matt-kosman/horticulture_panel/build/horticulture_panel_revA_schematic.pdf

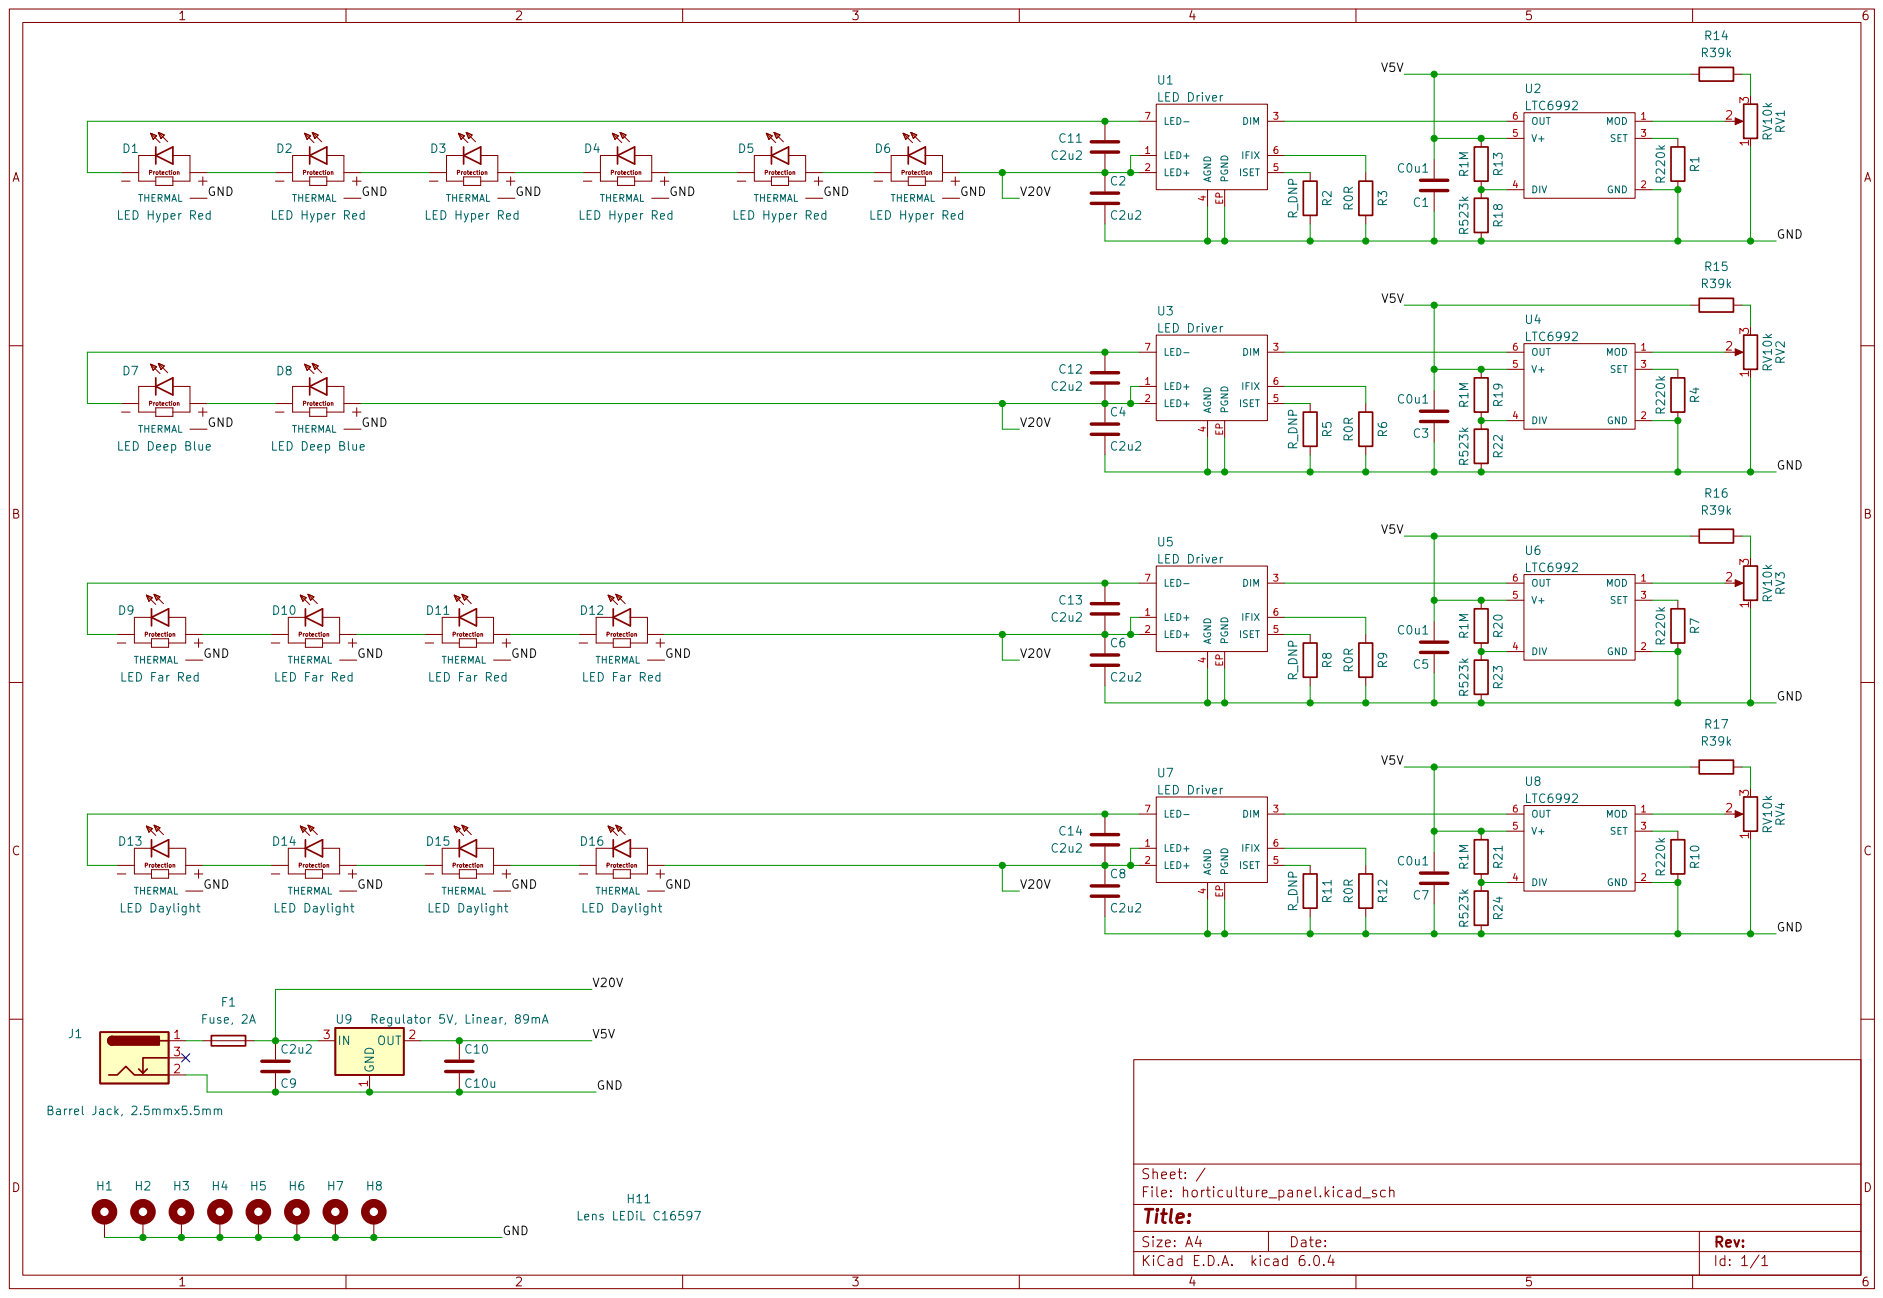
[picture p12: page 1]
