matt-kosman/horticulture_panel/kicad/horticulture_panel.kicad_pcb

## KiCad design kicad/horticulture_panel.kicad_pcb (2022-03-29)

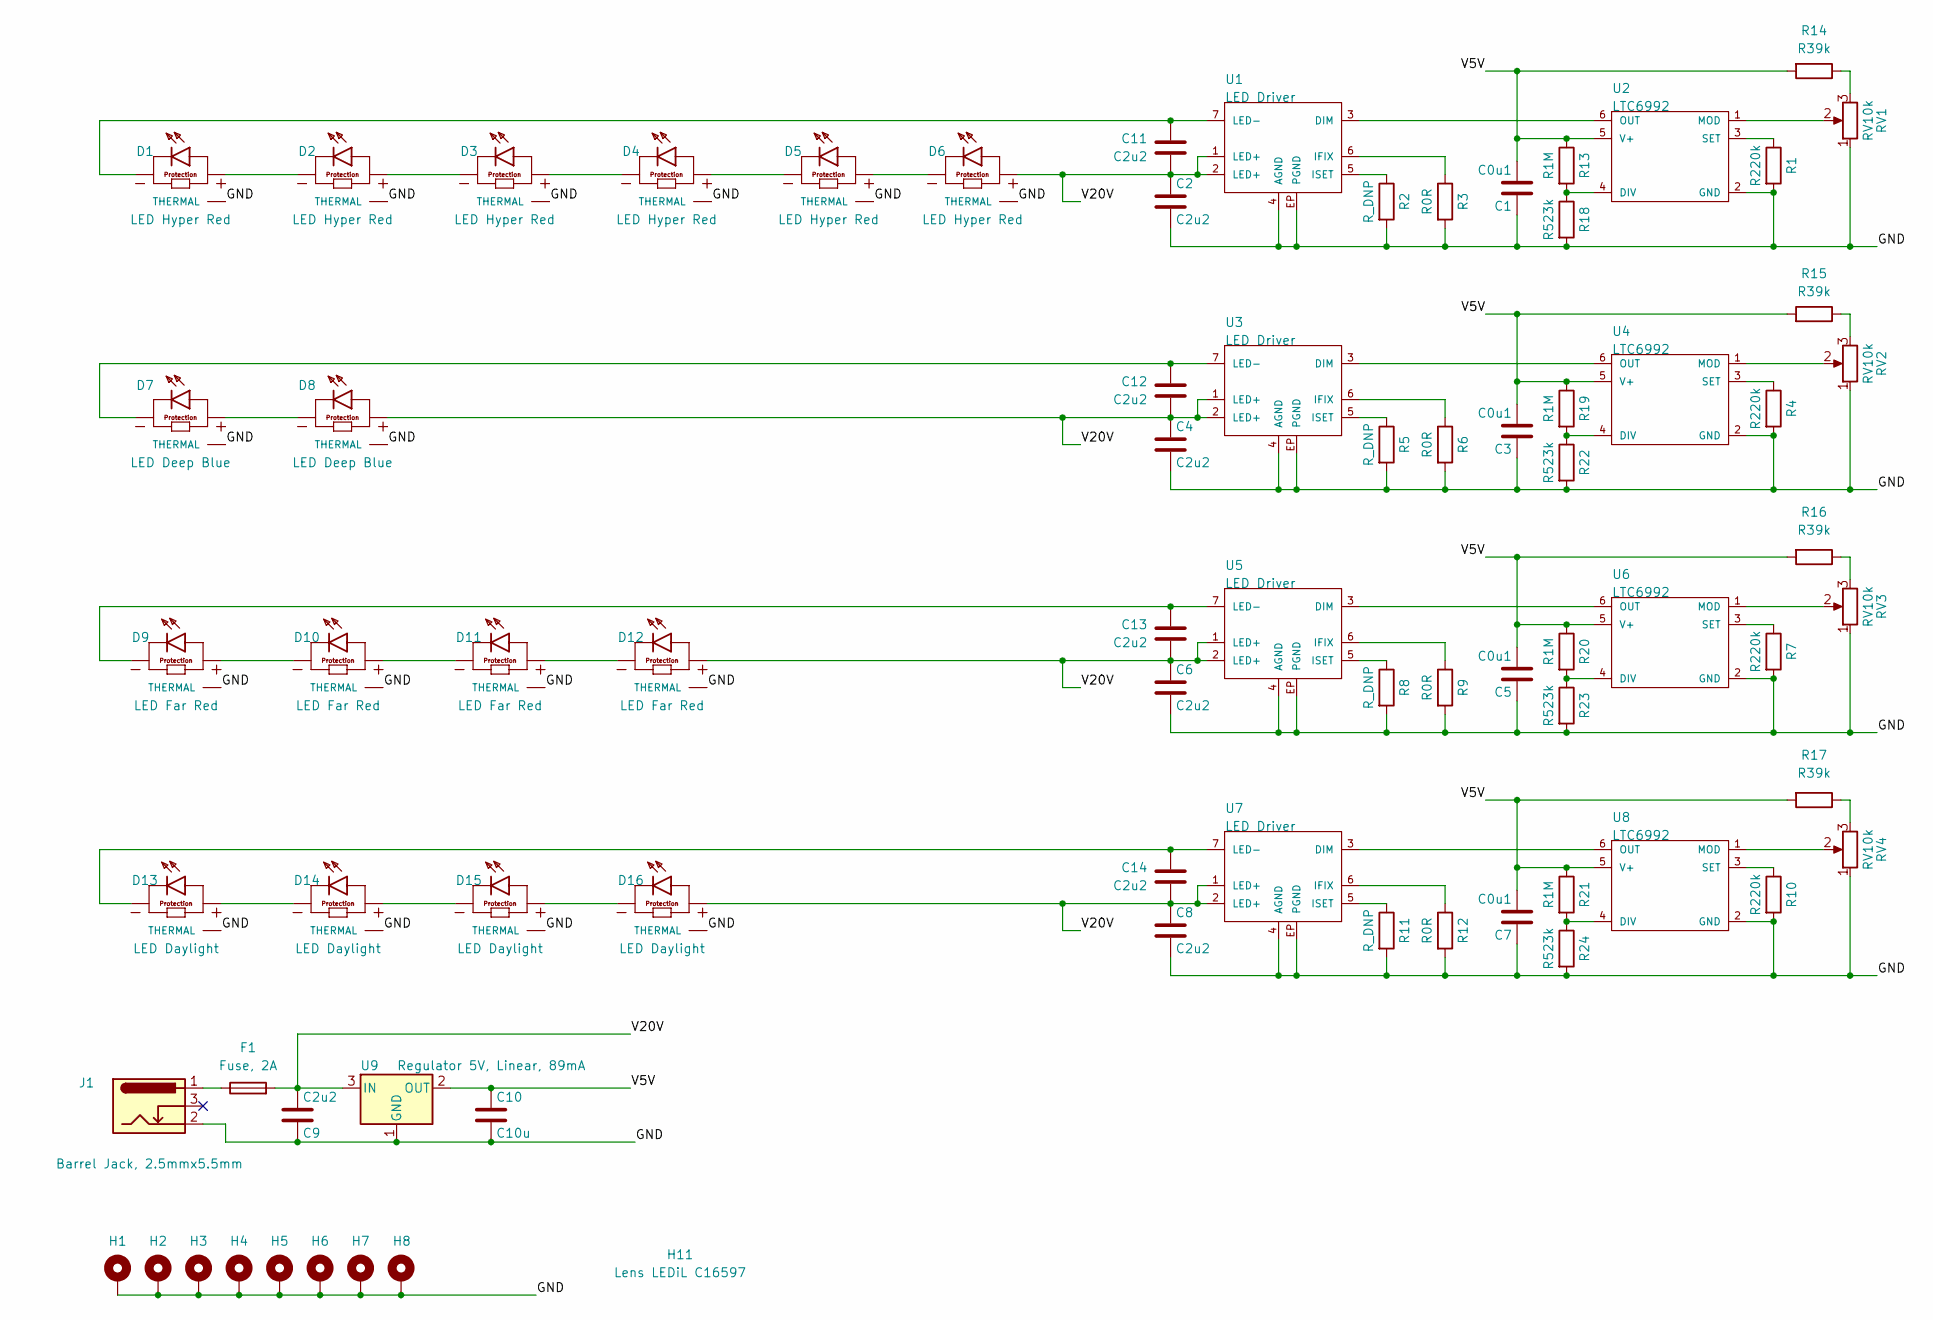
[picture p13: schematic horticulture_panel.kicad_sch]

Parts:
C1, C3, C5, C7: C0u1; C0805; MPN CL21B104KBCNNNC
C2, C4, C6, C8, C9, C11, C12, C13, C14: C2u2; C1210; MPN CL32B225KCJSNNE
C10: C10u; C0805; MPN CL21B106KPQNNNE
D1, D2, D3, D4, D5, D6: LED Hyper Red; Wurth Elektronik 3535 LED; MPN 150353HS74500
D7, D8: LED Deep Blue; Wurth Elektronik 3535 LED; MPN 150353DS74500
D9, D10, D11, D12: LED Far Red; Wurth Elektronik 3535 LED; MPN 150353FS74500
D13, D14, D15, D16: LED Daylight; Wurth Elektronik 3535 LED; MPN 158353050
F1: Fuse, 2A; Littelfuse 154; MPN 0154002.DR
H1, H2, H3, H4, H5, H6, H7, H8: Mounting Hole; Mounting Hole #4
H11: Lens LEDiL C16597; LEDiL C16597; MPN C16597
J1: Barrel Jack, 2.5mmx5.5mm; CUI PJ-036BH; MPN PJ-036BH-SMT-TR
R1, R4, R7, R10: R220k; R0805; MPN RMCF0805JT220K
R2, R5, R8, R11: R_DNP; DNP_0805
R3, R6, R9, R12: R0R; R0805; MPN RMCF0805ZT0R00
R13, R19, R20, R21: R1M; R0805; MPN RMCF0805JT1M00
R14, R15, R16, R17: R39k; R0805; MPN RMCF0805JT39K0
R18, R22, R23, R24: R523k; R0805; MPN RMCF0805FT523K
RV1, RV2, RV3, RV4: RV10k; PSM050S-10; MPN PSM050S-10B10KB
U1, U3, U5, U7: LED Driver; Wurth Elektronik LED Driver TO-263-7; MPN 172946001
U2, U4, U6, U8: LTC6992; SOT-23-6; MPN LTC6992
U9: Regulator 5V, Linear, 89mA; SOT-23; MPN ZXTR2105F-7

Connections:
/GND: C1.1, C2.2, C3.1, C4.2, C5.1, C6.2, C7.1, C8.2, C9.1, C10.2, D1.3 (THERMAL), D2.3 (THERMAL), D3.3 (THERMAL), D4.3 (THERMAL), D5.3 (THERMAL), D6.3 (THERMAL), D7.3 (THERMAL), D8.3 (THERMAL), D9.3 (THERMAL), D10.3 (THERMAL), D11.3 (THERMAL), D12.3 (THERMAL), D13.3 (THERMAL), D14.3 (THERMAL), D15.3 (THERMAL), D16.3 (THERMAL), H1.1, H2.1, H3.1, H4.1, H5.1, H6.1, H7.1, H8.1, J1.2, R1.2, R2.2, R3.2, R4.2, R5.2, R6.2, R7.2, R8.2, R9.2, R10.2, R11.2, R12.2, R18.2, R22.2, R23.2, R24.2, RV1.1, RV2.1, RV3.1, RV4.1, U1.4 (AGND), U1.EP (PGND), U2.2 (GND), U3.4 (AGND), U3.EP (PGND), U4.2 (GND), U5.4 (AGND), U5.EP (PGND), U6.2 (GND), U7.4 (AGND), U7.EP (PGND), U8.2 (GND), U9.1 (GND)
/V5V: C1.2, C3.2, C5.2, C7.2, C10.1, R13.1, R14.2, R15.2, R16.2, R17.2, R19.1, R20.1, R21.1, U2.5 (V+), U4.5 (V+), U6.5 (V+), U8.5 (V+), U9.2 (OUT)
/V20V: C2.1, C4.1, C6.1, C8.1, C9.2, C11.1, C12.1, C13.1, C14.1, D6.2, D8.2, D12.2, D16.2, F1.2, U1.1 (LED+), U1.2 (LED+), U3.1 (LED+), U3.2 (LED+), U5.1 (LED+), U5.2 (LED+), U7.1 (LED+), U7.2 (LED+), U9.3 (IN)
unnamed: C11.2, D1.1, U1.7 (LED-)
unnamed: C12.2, D7.1, U3.7 (LED-)
unnamed: C13.2, D9.1, U5.7 (LED-)
unnamed: C14.2, D13.1, U7.7 (LED-)
unnamed: D1.2, D2.1
unnamed: D2.2, D3.1
unnamed: D3.2, D4.1
unnamed: D4.2, D5.1
unnamed: D5.2, D6.1
unnamed: D7.2, D8.1
unnamed: D9.2, D10.1
unnamed: D10.2, D11.1
unnamed: D11.2, D12.1
unnamed: D13.2, D14.1
unnamed: D14.2, D15.1
unnamed: D15.2, D16.1
unnamed: F1.1, J1.1
unnamed: R1.1, U2.3 (SET)
unnamed: R2.1, U1.5 (ISET)
unnamed: R3.1, U1.6 (IFIX)
unnamed: R4.1, U4.3 (SET)
unnamed: R5.1, U3.5 (ISET)
unnamed: R6.1, U3.6 (IFIX)
unnamed: R7.1, U6.3 (SET)
unnamed: R8.1, U5.5 (ISET)
unnamed: R9.1, U5.6 (IFIX)
unnamed: R10.1, U8.3 (SET)
unnamed: R11.1, U7.5 (ISET)
unnamed: R12.1, U7.6 (IFIX)
unnamed: R13.2, R18.1, U2.4 (DIV)
unnamed: R14.1, RV1.3
unnamed: R15.1, RV2.3
unnamed: R16.1, RV3.3
unnamed: R17.1, RV4.3
unnamed: R19.2, R22.1, U4.4 (DIV)
unnamed: R20.2, R23.1, U6.4 (DIV)
unnamed: R21.2, R24.1, U8.4 (DIV)
unnamed: RV1.2, U2.1 (MOD)
unnamed: RV2.2, U4.1 (MOD)
unnamed: RV3.2, U6.1 (MOD)
unnamed: RV4.2, U8.1 (MOD)
unnamed: U1.3 (DIM), U2.6 (OUT)
unnamed: U3.3 (DIM), U4.6 (OUT)
unnamed: U5.3 (DIM), U6.6 (OUT)
unnamed: U7.3 (DIM), U8.6 (OUT)

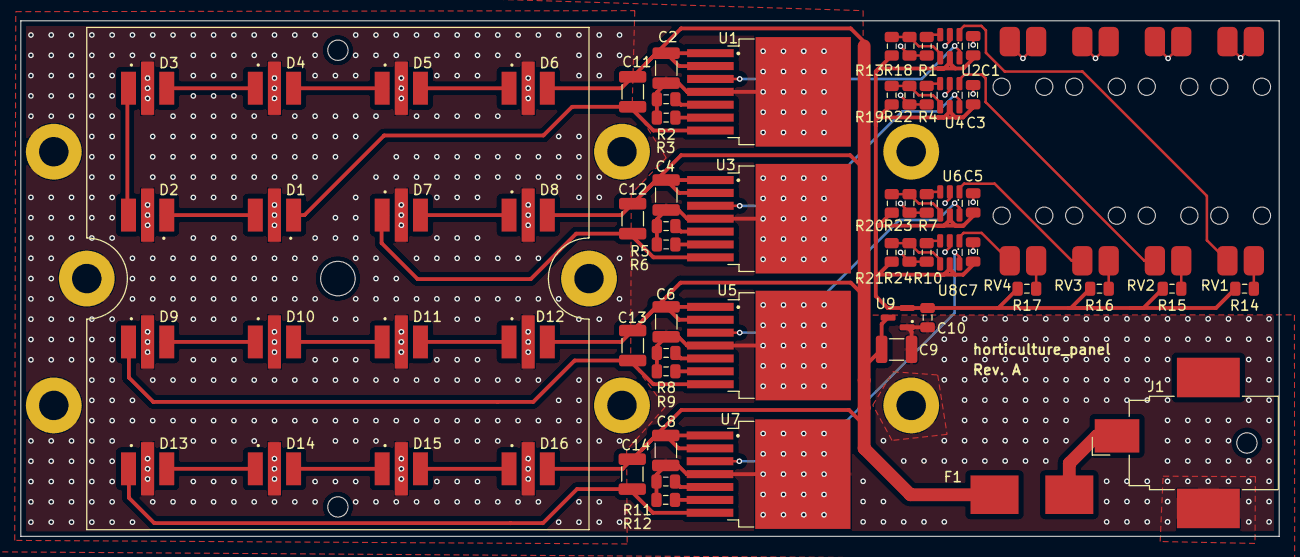
[picture p14: board horticulture_panel.kicad_pcb from above]

Board: 2 copper layers, 124.0 x 50.8 mm, 78 parts (0 on the bottom side), 48 nets.
